tonyseing/dog_exercise_machine/README.md

Dog Casino
==========

This is an exercise machine for dogs that dispense dog treats whenever a dog runs through multiple points, triggering ultrasonic sensors.
