tonyseing/dog_exercise_machine/blueprint.jpg

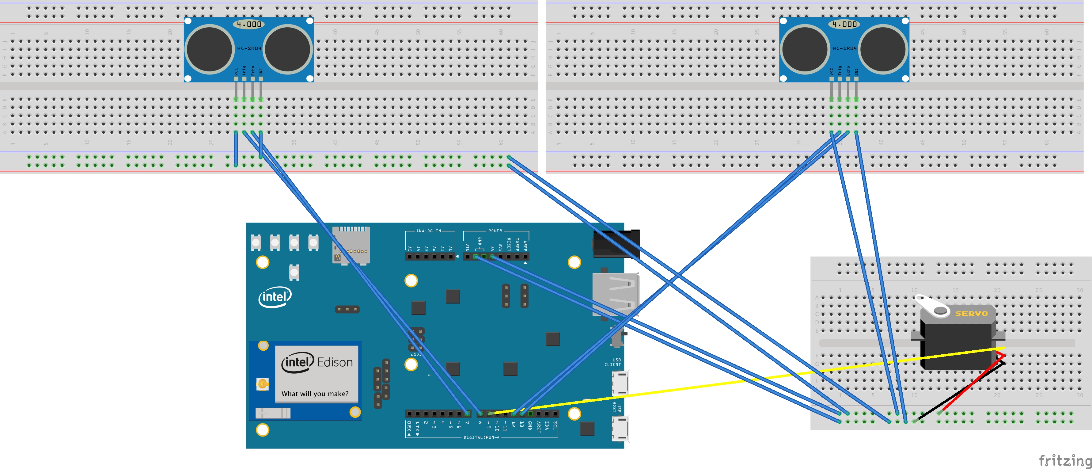
blueprint.jpg
