tonyseing/dog_exercise_machine/schematic.jpg

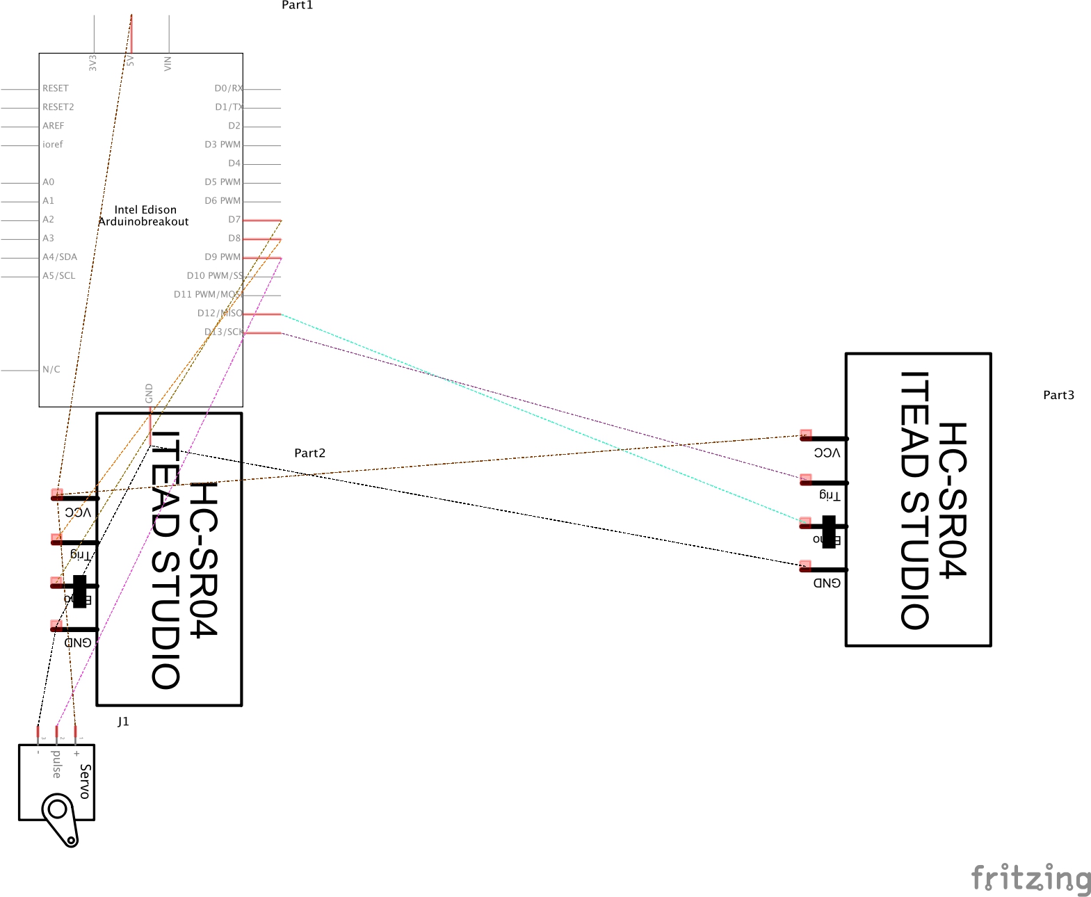
schematic.jpg
