tonyseing/dog_exercise_machine/(list of files, drawings)

Other design files:
blueprint.fzz
