tonyseing/dog_exercise_machine/howto.md

# How to make an exercise machine for your dog

###Introduction

The good folks at Intel Mashery were nice enough to send me a free Intel Edison. They asked me to make something cool with it. 

For those who haven't seen one before, it looks like this:



My dog is currently away at my parents' home in Connecticut, so I have missed her a lot. I decided to make her a gift for Christmas. The device is an exercise machine to keep her occupied when I have to leave her at home alone.

Adorable dog Adorable Dog

### How it works

I thought of a dozen other contraptions before I settled on what I realize now was probably the simplest, most practical design. The requirements for the machine were: automatically provide food for the dog when she proved that she had done some physical work. This machine be flexible enough to work in both large and confined spaces. I live in a smallish apartment in the New York City area, so it would be unfeasible for me to have such a contraption if it required ownership of a yard.

I thought of systems requiring rope and pulleys to dangle something my dog would chase, but I decided that they were too large and that constant jumping could lead to back problems for dogs.

I decided to place two boxes far apart from each other, and affix ultrasonic sensors to the top of them. The sensors would detect when the dog was passing through, and when she has passed through both, the machine would use a servo motor to open the mouth to a funnel of dog food for a quick moment, releasing a small parcel of dog treats.

###What you'll need

* 1 bored dog
* 3 moderately large boxes
* 1 Arduino board -- I used an Intel Edison microprocessor with an Arduino breakout board
* 2 HC-SR04 ultrasonic sensors
* 1 standard servo
* Duct tape
* 3 breadboards
* Insulated 22cm copper wire
* Scissors

The bare necessities

### Electronics

I've provided a schematic of how the machine is wired for clarity. I created the schematic in Fritzing. 



Essentially, you'll affix two ultrasonic sensors to breadboards and your breakout board. The HC-SR04 has four pins:

VCC: +5V DC
Trig : Trigger (INPUT)
Echo: Echo (OUTPUT)
GND: GND

We're going to send out a pulse through the echo and track the time required for the sound to come back to the sensor. This will give us an idea of how far away an object is from the sensor, which in our case, is a dog. 

Then, you will hook up your servo by wiring 5v to the power pin, ground to the ground pin, and the signal pin to pin 9 on your arduino board. For most servos, the red wire will be for your power, white or orange for your signal, and brown or black for your ground. I found this useful chart at http://www.bpesolutions.com/:



----------
###Code

The accompanying Ardiuno setup code to make these sensors work looks like this:

    int echo_pins[2] = {7, 12};
    int trig_pins[2] = {8, 13};
    pinMode(trig_pins[0], OUTPUT);
    pinMode(echo_pins[0], INPUT);  
    pinMode(trig_pins[1], OUTPUT);
    pinMode(echo_pins[1], INPUT);  

In your loop function, your code will look like this:

    digitalWrite(trig_pins[boxNumber], LOW); 
    delayMicroseconds(2); // low for 2 microseconds
    digitalWrite(trig_pins[boxNumber], HIGH);
    delayMicroseconds(10); // high for 10 microseconds
    digitalWrite(trig_pins[boxNumber], LOW);
    duration = pulseIn(echo_pins[boxNumber], HIGH); // measure the time to the echo
    distance = (duration / 2) / 29.1;  

This block of code shoots a soundwave out from our sensor and tracks the time it takes to echo back. You'll then use this distance to make decisions about triggering the servo.

Here is the entire function detecting if your dog has passed through both box checkpoints:

    boolean is_something_there (int boxNumber) {
       long duration, distance;
     
      // send the pulse
       boolean dog_detected = false;
       digitalWrite(trig_pins[boxNumber], LOW); 
       delayMicroseconds(2); // low for 2 microseconds
       digitalWrite(trig_pins[boxNumber], HIGH);
       delayMicroseconds(10); // high for 10 microseconds
       digitalWrite(trig_pins[boxNumber], LOW);
       duration = pulseIn(echo_pins[boxNumber], HIGH); // measure the time to the echo
       distance = (duration / 2) / 29.1;  // calculate the distance in centimeters

       if (distance < triggerBoundary) {
         Serial.println("DOG DETECTED");  
         Serial.println(distance);   
         dog_detected = true;
       }
       else {
         Serial.println("NO DOG DETECTED");
         Serial.println(distance);
       }
          
       return dog_detected;
    }

The code to power your servo is equally simple. You're simply going to iterate a variable from 0 to 180 over a period of time, and set the servo arm angle to that variable. This will shutter your dog treat feeder's mouth open and closed.

    void feedDog() {
      // turn 180 degrees in one direction
      for(servo_angle = 0; servo_angle < 180; servo_angle++)  
      {                                  
        servo.write(servo_angle);               
        delay(20);                   
      } 
      
      // now turn back 180 degrees to 0 degrees
      for(servo_angle = 180; servo_angle > 0; servo_angle--)    
      {                                
        servo.write(servo_angle);           
        delay(20);       
      } 
    }

Here is a video of me testing my ultrasonic-sensor triggered servo:
https://www.youtube.com/watch?v=shv30x-xJkk
Hopefully this gives you an indication of what we are trying to achieve.

You can find the entire Arduino source code at: https://github.com/tonyseing/dog_exercise_machine.git

----------

### Casing

You'll use a small box to affix your servo to. I used an old box my cell phone came packaged in. You'll mark the shape of your servo along the middle of the box turned on its side. And you'll slide your servo in like so:



Place your servo in a larger box, and cut an opening from the top to the bottom, with the largest surface of the box placed on the ground. This opening should be the width of your servo, and should be snug enough to allow it to slide in. Use duct tape to secure it.





Now, cut a circular piece of any discarded cardboard, large enough to fill the opening of your servo's outer box. Screw your servo arms to this piece of cardboard (duct tape will work if you can't find any screws that will fit). Cut a pizza-shaped slice out of the circular piece of cardboard from the center. This should be roughly 1/6th of the surface area of the circular piece of cardboard.





Next, you'll cut one opening each at the top of two large boxes, just large enough for your ultrasonic sensors to poke their heads through.



Use zip-ties to reinforce the structural integrity of your sensor boxes. Fastening the corners of your two boxes with zip-ties will prevent your boxes from collapsing. 



Now duct tape your sensors affixed to the top of your sensor boxes.



Cut a face off a large cardboard box, and fold it in half lengthwise. We'll use this as a makeshift funnel, to hold the dog food. Place one end on top of your servo box, and the other end into the mouth you had cut for the servo. Make sure the funnel does not go beyond the opening of the box, and try to create as little of an opening as possible, to avoid having food spill into your servo's casing. Use duct tape to hold this funnel in place. 

 

A look inside our servo's casing: 


Now you're all set to go! When your dog runs through both boxes, your servo will turn 180 degrees momentarily, letting out some much-deserved treats for your pooch. 

Here is a picture of the entire setup. Please don't tell people how messy my apartment is.
