tonyseing/dog_exercise_machine/(commit log)

2014-12-08 ultrasonic sensor reading and code v.0.1 ok
2014-12-09 works with servo now
2014-12-10 adds code for on off switch
2014-12-17 accounts for second sensor box
2014-12-17 makes servo wait time consistent
2014-12-17 adds schematics
    [blueprint.fzz]
2014-12-17 adds howto
    [blueprint.fzz]
